ali-ghazi78/audiometer/(list of files, drawings)

Other design files:
audiometer_karshenasi/audiometr/audiometer.PcbDoc
audiometer_karshenasi/audiometr/audiometr.PrjPcb
gozaresh/audiometer_gozaresh_2/audiometer.SchDoc
