ali-ghazi78/audiometer/Core/Src/main.c

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

/* Includes ------------------------------------------------------------------*/
#include "main.h"

/* USER CODE BEGIN Includes */

 I2C_HandleTypeDef hi2c1;
 SPI_HandleTypeDef hspi1;

#include "ssd1306_my.h"
#include "stm32f1xx_hal_i2c.h"
#include "ad9833.h"
/* USER CODE END Includes */

I2C_HandleTypeDef hi2c1;

SPI_HandleTypeDef hspi1;

TIM_HandleTypeDef htim1;
TIM_HandleTypeDef htim2;

/* USER CODE BEGIN PV */


int32_t pulse =100;
int32_t db=100;
char state2=0;
char state=0;


/* USER CODE END PV */

void SystemClock_Config(void);
static void MX_GPIO_Init(void);
static void MX_I2C1_Init(void);
static void MX_SPI1_Init(void);
static void MX_TIM1_Init(void);
static void MX_TIM2_Init(void);
/* USER CODE BEGIN PFP */



uint32_t counter = 0 ;

/* USER CODE END PFP */

/**
  * @brief  The application entry point.
  * @retval int
  */
int main(void)
{
  /* MCU Configuration--------------------------------------------------------*/

  /* Reset of all peripherals, Initializes the Flash interface and the Systick. */
  HAL_Init();

  /* Configure the system clock */
  SystemClock_Config();

  /* Initialize all configured peripherals */
  MX_GPIO_Init();
  MX_I2C1_Init();
  MX_SPI1_Init();
  MX_TIM1_Init();
  MX_TIM2_Init();
  /* USER CODE BEGIN 2 */
//asd
  /* USER CODE END 2 */

  /* Infinite loop */
  /* USER CODE BEGIN WHILE */



  ssd1306_Init();

  ssd1306_Fill(Black);
  ssd1306_WriteString("salam chetori", Font_7x10, White);
  ssd1306_UpdateScreen();

  HAL_TIM_Base_Start_IT(&htim2);

  HAL_TIM_Encoder_Start(&htim1, TIM_CHANNEL_ALL);

  while (1)
  {
    /* USER CODE END WHILE */

    /* USER CODE BEGIN 3 */


	  db = TIM1->CNT;
	  db*=100;
	  ssd1306_SetCursor(0, 14);
	  ssd1306_WriteString("freq = ", Font_7x10, White);
	  ssd1306_PutInt(pulse ,Font_7x10, White);
	  ssd1306_WriteString("        ", Font_7x10, White);
	  ssd1306_SetCursor(0, 23);
	  ssd1306_WriteString("db   = ", Font_7x10, White);
	  ssd1306_PutInt(db ,Font_7x10, White);
	  ssd1306_WriteString("        ", Font_7x10, White);
	  ssd1306_SetCursor(0,  30);
	  ssd1306_WriteString("c   = ", Font_7x10, White);
	  ssd1306_PutInt(state2,Font_7x10, White);
	  ssd1306_WriteString("        ", Font_7x10, White);




	  ssd1306_UpdateScreen();
	  ad9833_set_mode_and_freq(ad9833_sin, db );
	 // ad9833_disable();
	  //ssd1306_ClearScreen();

//	  if(db!=HAL_GPIO_ReadPin(encod1_GPIO_Port,encod1_Pin))
//	 {
//		  if(HAL_GPIO_ReadPin(dir1_GPIO_Port,dir1_Pin))
//		  {
//			  pulse++;
//		  }
//		  else
//		  {
//			  pulse--;
//		  }
//	 }
  }
  /* USER CODE END 3 */
}

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
/* USER CODE BEGIN 4 */



 void HAL_TIM_PeriodElapsedCallback(TIM_HandleTypeDef *htim)
 {

//	 HAL_GPIO_TogglePin(GPIOC, GPIO_PIN_13);
	 state2 ++ ;
	 if(state2>250)
		 state2=250;
 }



 void HAL_GPIO_EXTI_Callback(uint16_t GPIO_Pin)
{

	 char valid = 0;
	 __HAL_TIM_DISABLE(&htim2);

	 counter =	__HAL_TIM_GET_COUNTER(&htim2);

	 if(state2>=2&&state2<=50)
	 {
		 valid = 1;

	 }
	 else
		 valid =0 ;



	 if(valid)
	 {

		if(GPIO_Pin == encod1_Pin)
		{
			  if(state==0)
			  {
				  pulse+=1;
				  if(pulse>20000)
					  pulse=0;
			  }
			  else
			  {
				  pulse-=1;
				  if(pulse<0)
					  pulse=20000;

			  }
		}
	 }


	 if(HAL_GPIO_ReadPin(encod1_GPIO_Port,encod1_Pin)==1)
	 {
		 if(HAL_GPIO_ReadPin(dir1_GPIO_Port,dir1_Pin)==0)
		 {
			 state = 1 ;

		 }
		 else
		 {
			 state = 0 ;

		 }

	 }
	 else
	 {
		 if(HAL_GPIO_ReadPin(dir1_GPIO_Port,dir1_Pin)==1)
		 {
			 state = 1 ;

		 }
		 else
		 {
			 state = 0 ;

		 }

	 }
	 __HAL_TIM_SET_COUNTER(&htim2,0);
	 state2 = 0;

	 HAL_GPIO_TogglePin(GPIOC, GPIO_PIN_13);
	 __HAL_TIM_ENABLE(&htim2);

//	 __enable_irq();

  /* NOTE: This function Should not be modified, when the callback is needed,
           the HAL_GPIO_EXTI_Callback could be implemented in the user file
   */
}
/* USER CODE END 4 */
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
