ali-ghazi78/audiometer/audiometer.ioc

Mcu.UserName=STM32F103C8Tx
PA13.Signal=SYS_JTMS-SWDIO
PA14.Signal=SYS_JTCK-SWCLK
PA4.Signal=GPIO_Output
PA5.Signal=SPI1_SCK
PA7.Signal=SPI1_MOSI
PA8.Signal=S_TIM1_CH1
PA9.Signal=S_TIM1_CH2
PB12.GPIO_Label=key1
PB12.Signal=GPIO_Input
PB13.GPIO_Label=dir1
PB13.Signal=GPIO_Input
PB14.GPIO_Label=encod1
PB14.Signal=GPXTI14
PB15.GPIO_Label=key2
PB15.Signal=GPIO_Input
PB6.Signal=I2C1_SCL
PB7.Signal=I2C1_SDA
PC13-TAMPER-RTC.Signal=GPIO_Output
