ali-ghazi78/audiometer/(commit log)

2020-07-22 ssd1306 oled setuped stm32
    [audiometer1 Debug (1).cfg, audiometer1 Debug.cfg]
2020-07-26 encoder added one is debounce by hardware filter and one debounce by software
2020-08-22 diagram added
    [audiometer.SchDoc, audiometr.PrjPcb]
2020-08-22 smal edit font
    [audiometer.SchDoc]
